xzhang03/NidaqGUI/PCBs/LED cue pwmint/readme.md

LED cue takes a PWM signal and turns RGB LED on/off. 

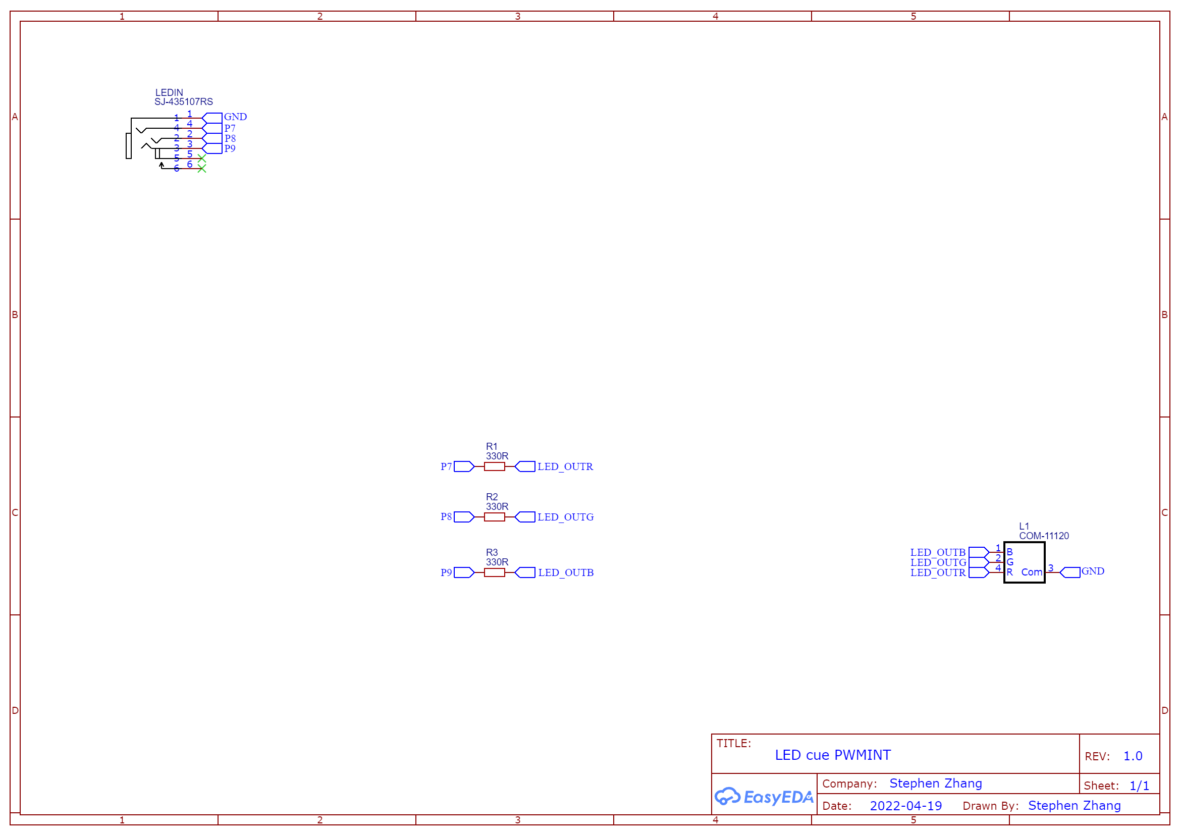
[picture p10: PCBs/LED cue pwmint/Schematic_LED-cue-pwm3_2026-06-25.png]
schematic
