xzhang03/NidaqGUI/PCBs/Nanosec/readme.md

## Notes
* Max 3.3V output current is 250 mA.
* No pin is 5V tolerant!
* Possible upgrades: DAC, EEPROM, status LEDs, independent 3.3V regulator, coin cell holder for onboard RTC.

## Schematics

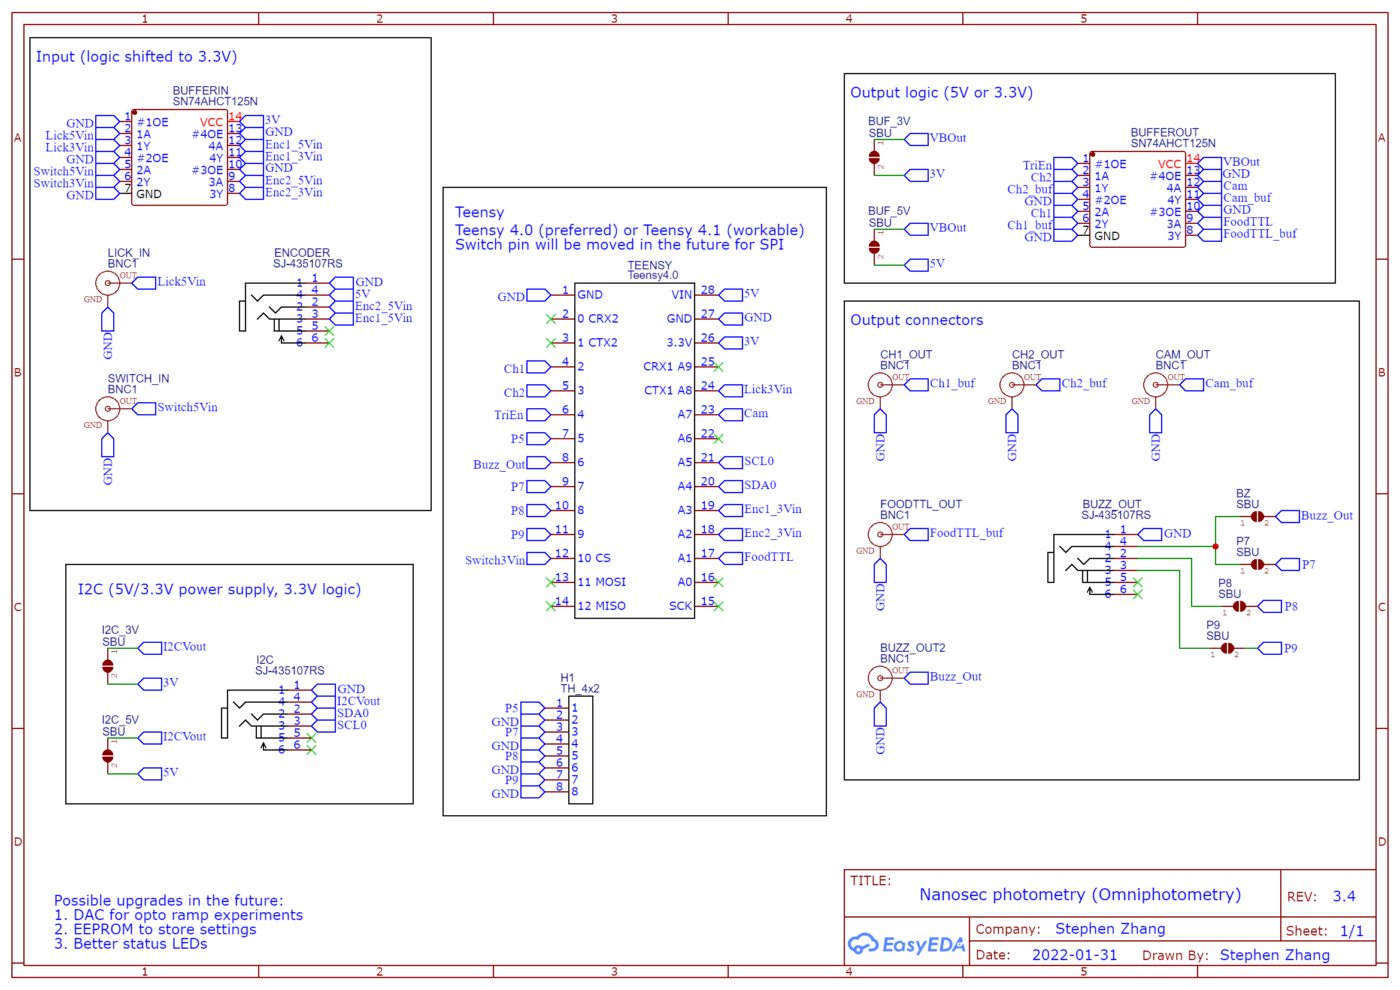
[picture p11: PCBs/Nanosec/Schematic_Omnibox-v3_2026-06-24.png]
Schematics


## Footprint

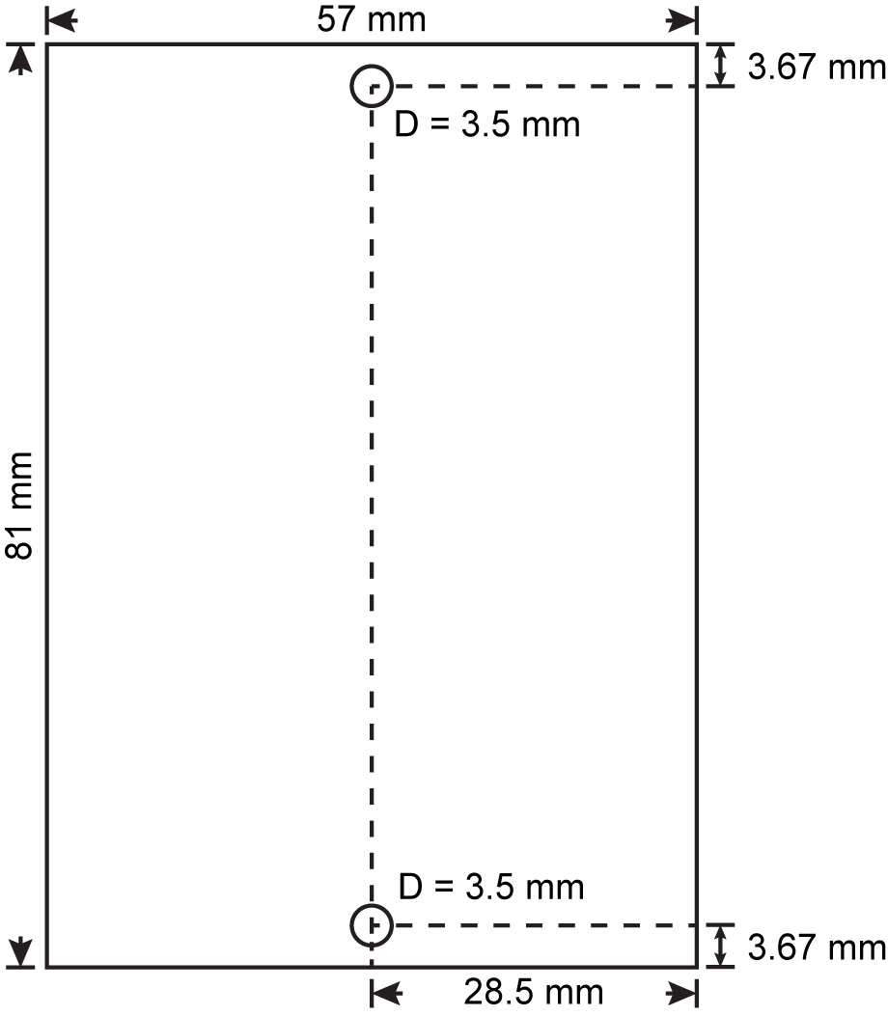
[picture p12: PCBs/Nanosec/Board footprint.png]
Footprint
