xzhang03/NidaqGUI/PCBs/LED cue/readme.md

LED cue takes a digital signal or PWM signal and turns LED on/off. The wavelength is programmed by a DIM switch on the board in this version as it is to plug in the buzzer cable. Use the I2c version for flexible wavelength control. Only 2 channels of the audio jack are used (LED+ and ground).

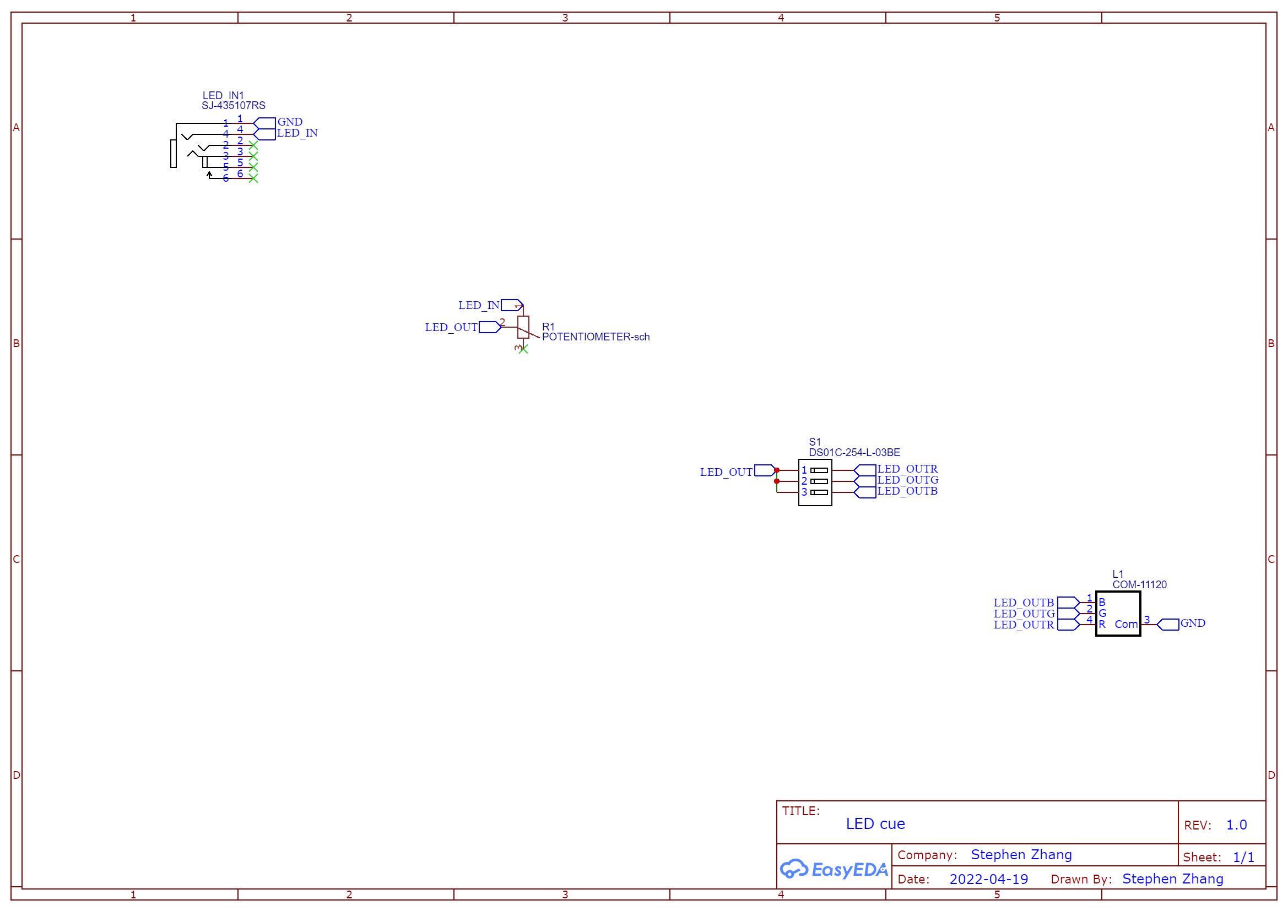
[picture p18: PCBs/LED cue/Schematic_LED cue_2022-04-19.png]
schematic
