xzhang03/NidaqGUI/PCBs/Buzzer/readme.md

Buzzer uses a PWM signl and turns it into a ~2.1 kHz buzz. The frequency of buzz is not programmable at the moment. Only two channels of the audio cable are used (buzz positive and ground).

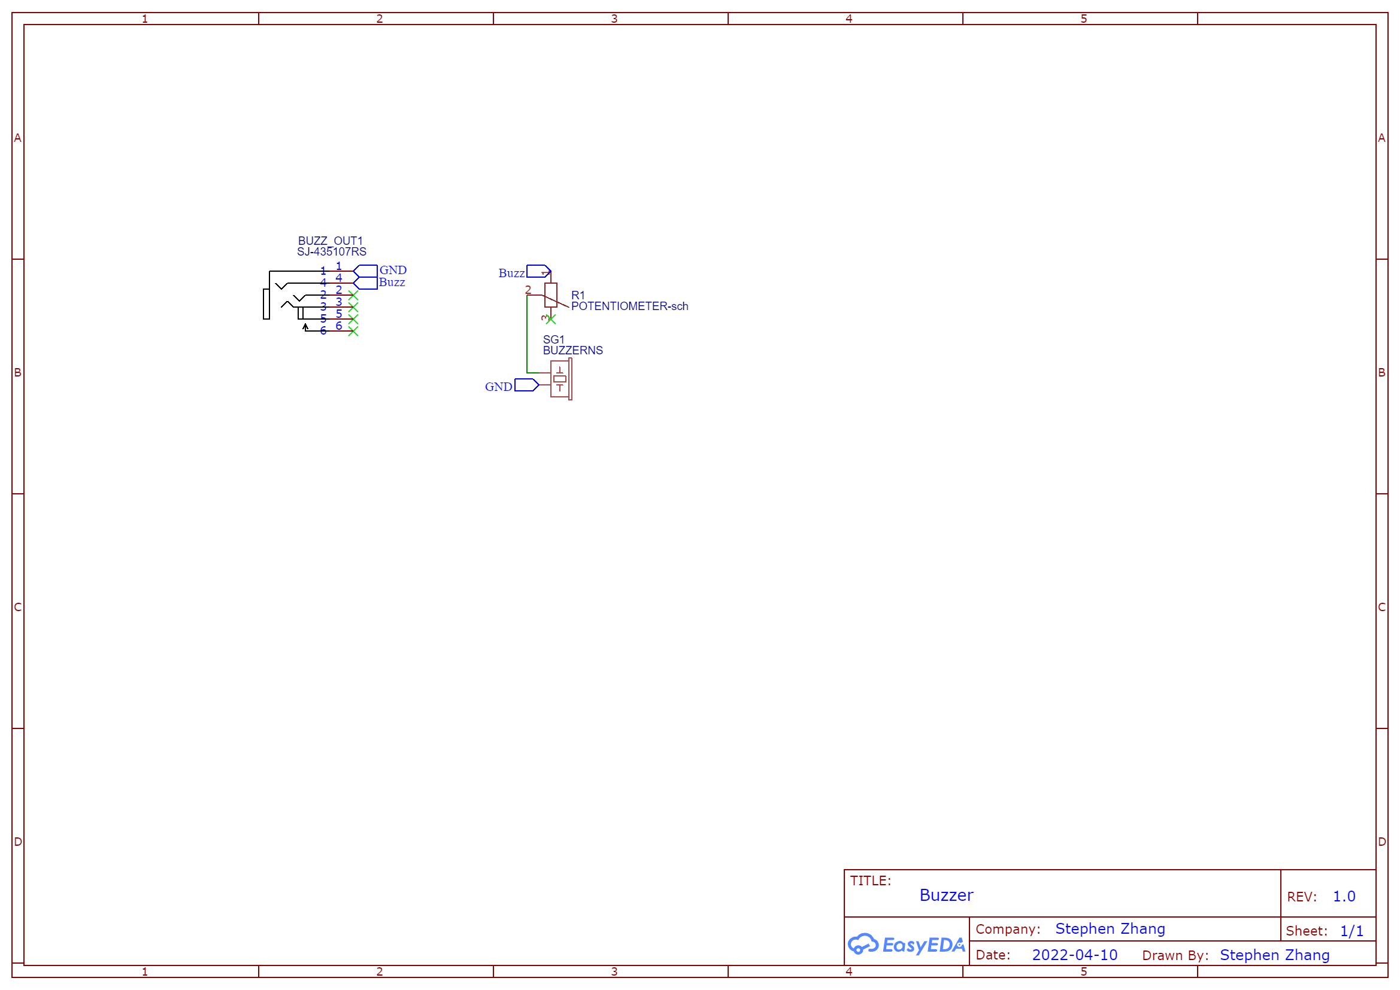
[picture p19: PCBs/Buzzer/Schematic_Buzzer_2022-04-13.png]
Schematic
