xzhang03/NidaqGUI/PCBs/Rotary Encoder/encoder_footprint.png

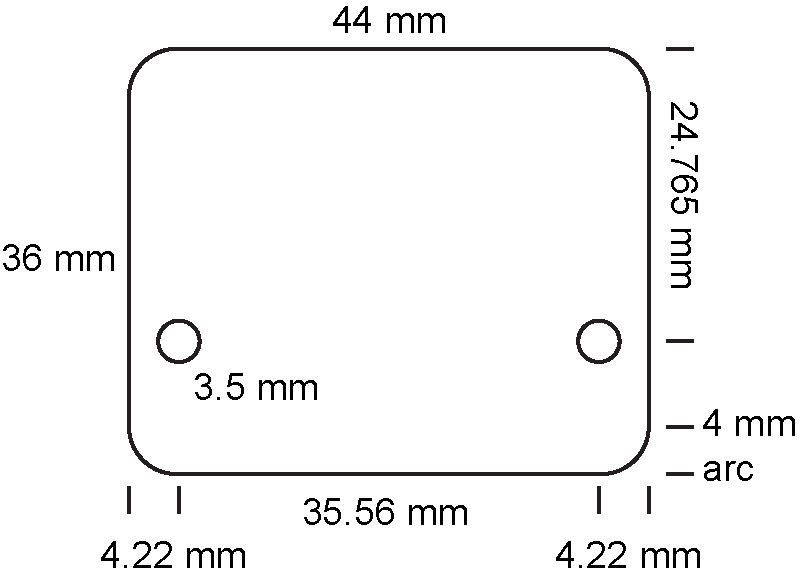
PCBs/Rotary Encoder/encoder_footprint.png
