xzhang03/NidaqGUI/PCBs/Shifter v2/Schematic_Nanosec-Shifter2_2025-11-14.png

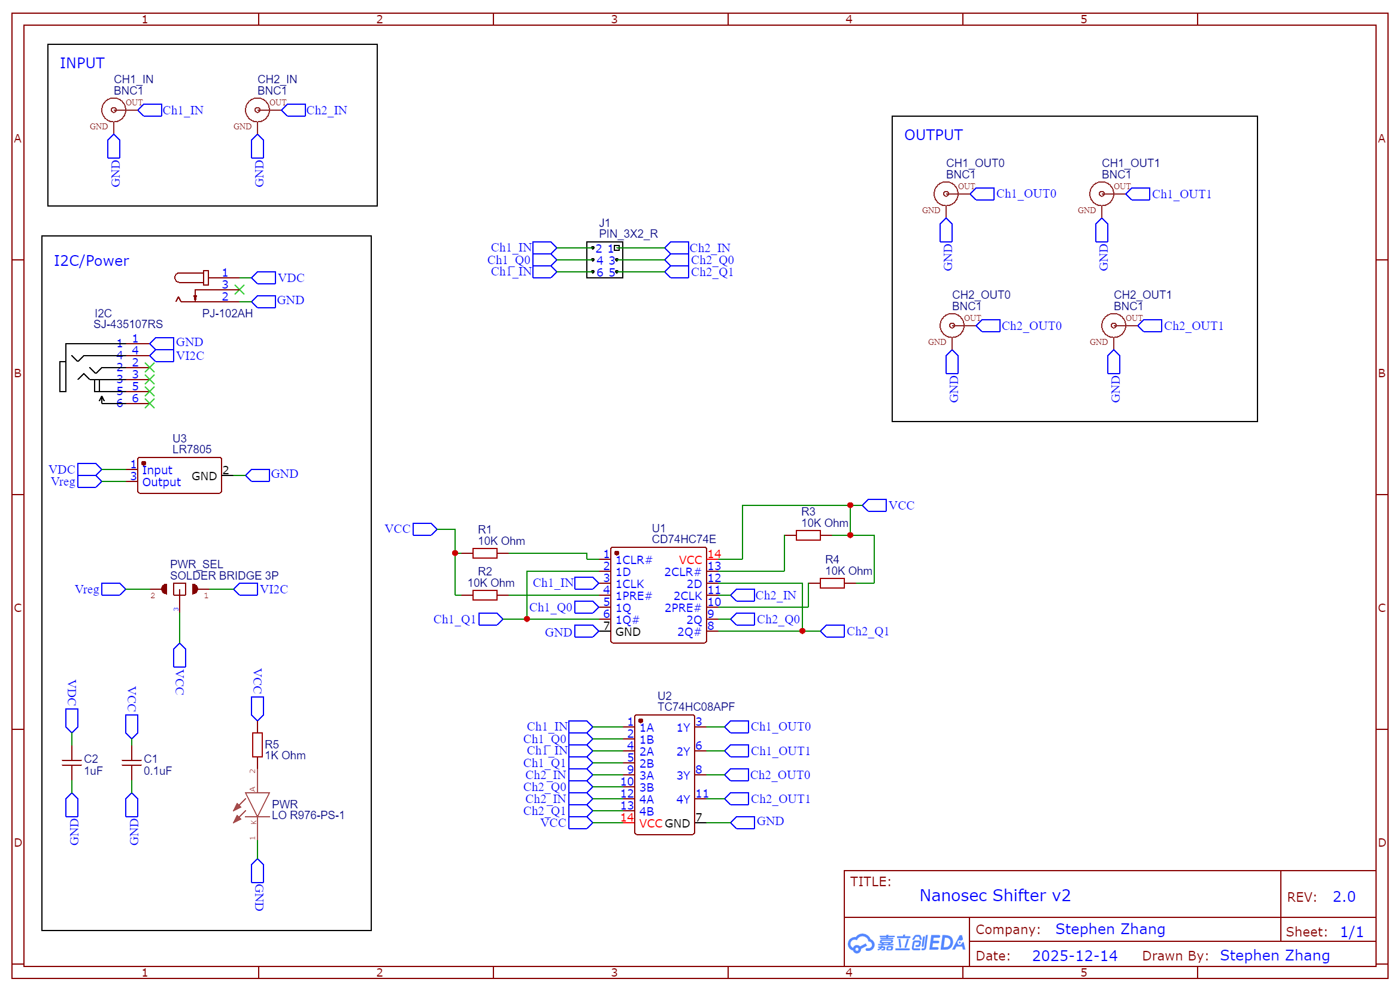
PCBs/Shifter v2/Schematic_Nanosec-Shifter2_2025-11-14.png
