xzhang03/NidaqGUI/Schemes/omnibox_half_breadboard.png

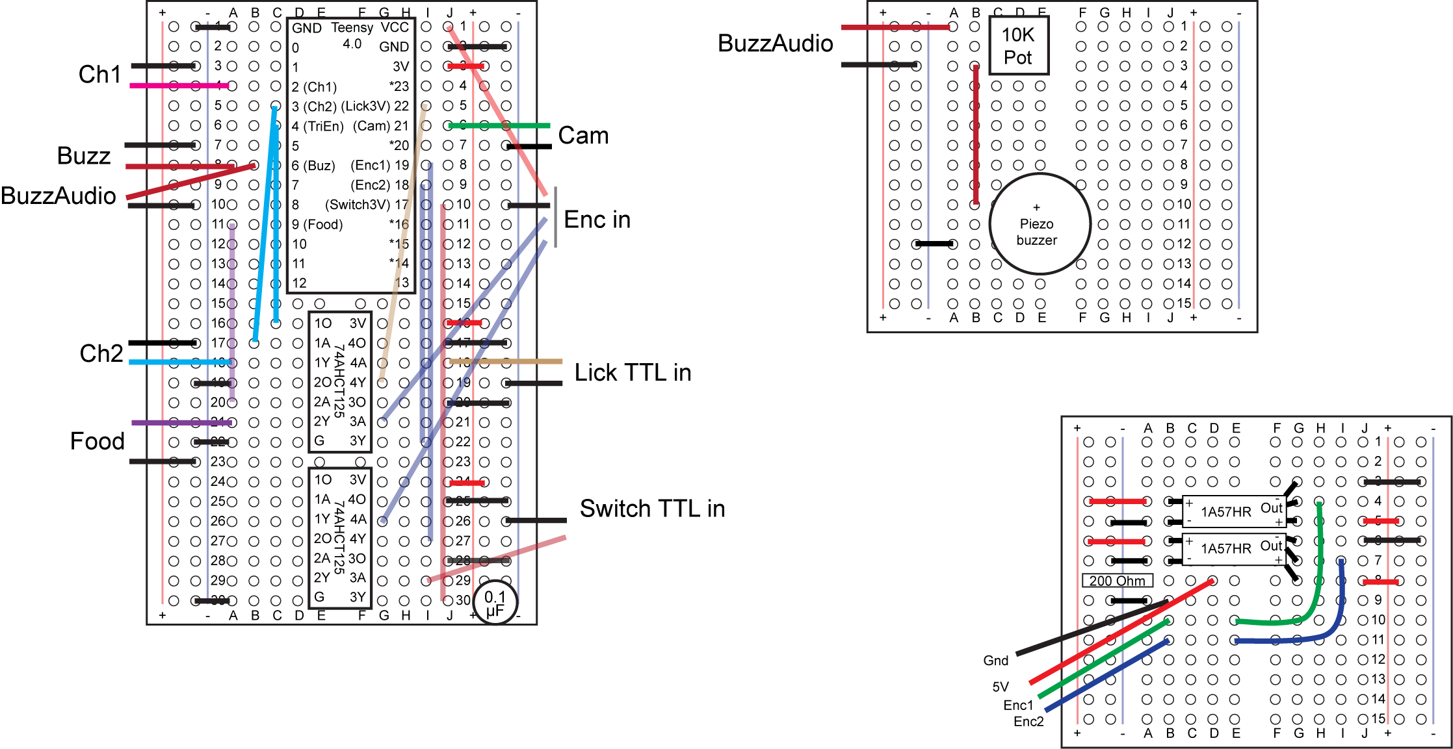
Schemes/omnibox_half_breadboard.png
