xzhang03/NidaqGUI/Schemes/Schematic_TQMux_2022-06-06.png

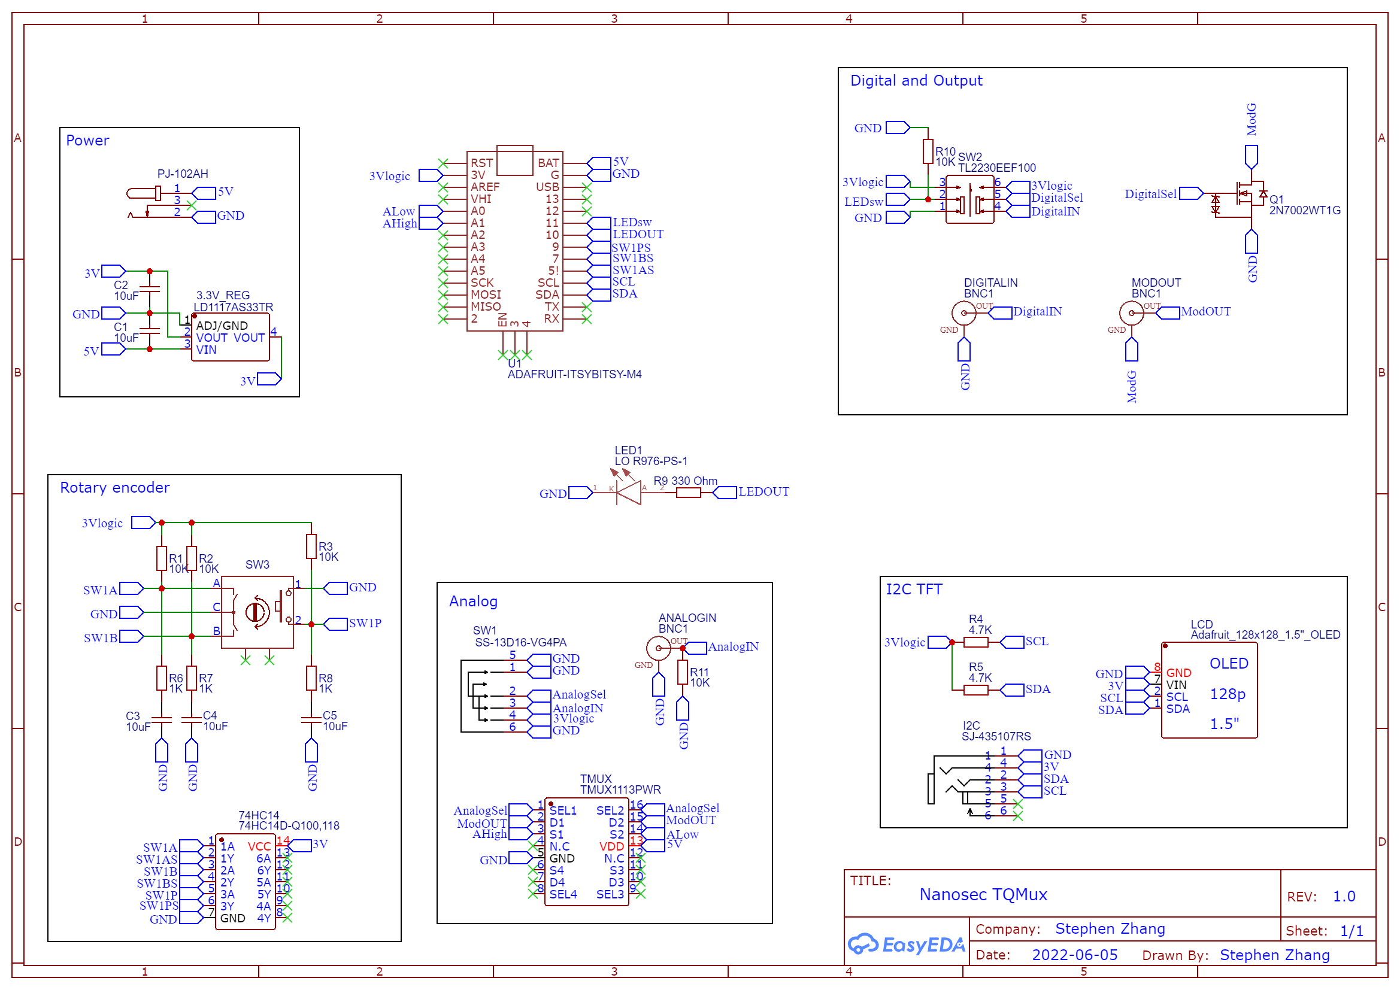
Schemes/Schematic_TQMux_2022-06-06.png
