xzhang03/NidaqGUI/PCBs/Buzzer/Nanosec Buzzer BOM.xlsx

Country of Origin may be different at time of shipment.
The HTSUS and ECCN information shown is for informational purposes only and is not a representation or warranty as to the accuracy or reliability of these classifications. All information is provided "as is" and is subject to change without notice. Any use made of the information provided is without recourse to Digi-Key and at the user's risk.
Index | Manufacturer Part Number | Manufacturer Name | Description | Availability | Stock Status | Attrition % | Requested Quantity 1 | Pack Quantity 1 | Pack Type 1 | Digi-Key Part Number 1 | Unit Price 1 | Extended Price 1 | Minimum Order Quantity 1 | Customer Reference | Requested Part Number | Lead Weeks | Datasheet | Reference Designator | US Import Tariff | Note | Part Status | RoHS Status | ECCN | HTSUS | Country of Origin | Environmental Information | Original Part numbers | Image
1 | CEM-1203(42) | CUI Devices | BUZZER MAGNETIC 3.5V 12MM TH | 66,838 | In Stock |  | 1 | 1 | Tray | 102-1153-ND | 0.75000 | $0.75 | 1 |  | 102-1153-ND | 15 | https://www.cuidevices.com/product/resource/cem-1203-42-.pdf |  | May apply on shipments to the U.S. |  | Active | ROHS3 Compliant | EAR99 | 8531.80.9041 | China | https://www.cuidevices.com/product/resource/material-compliance/cem-1203(42) | 102-1153-ND | //media.digikey.com/photos/CUI%20Photos/CEM-1203(42).jpg
2 | 3266Y-1-103LF | Bourns Inc. | TRIMMER 10K OHM 0.25W PC PIN TOP | 0 | Normally Stocking |  | 1 | 1 | Tube | 3266Y-1-103LF-ND | 4.20000 | $4.20 | 1 |  | 3266Y-1-103LF-ND | 15 | https://www.bourns.com/docs/Product-Datasheets/3266.pdf |  | N/A |  | Active | ROHS3 Compliant | EAR99 | 8533.40.8050 | Costa Rica | https://www.bourns.com/docs/rohs-content/bourns-reach-letter.pdf|https://www.bourns.com/docs/rohs-cofc/cofc_trim4.pdf?sfvrsn=41f62244_2 | 3266Y-1-103LF-ND | //media.digikey.com/Photos/Bourns%20Photos/3266Y-1-501LF.JPG
3 | SJ-435107RS | CUI Devices | CONN JACK 4COND 3.5MM R/A | 15,403 | In Stock |  | 1 | 1 | Tray | CP-435107RS-ND | 1.78000 | $1.78 | 1 |  | SJ-435107RS | 24 | https://www.cuidevices.com/product/resource/sj-435107.pdf |  | N/A |  | Active | ROHS3 Compliant | EAR99 | 8536.69.4040 | China | https://www.cuidevices.com/product/resource/material-compliance/sj-435107-series | SJ-435107RS | //media.digikey.com/Photos/CUI%20Photos/MFG_SJ-435107.jpg
