xzhang03/NidaqGUI/PCBs/LED cue/Nanosec LED Cue BOM.xlsx

Country of Origin may be different at time of shipment.
The HTSUS and ECCN information shown is for informational purposes only and is not a representation or warranty as to the accuracy or reliability of these classifications. All information is provided "as is" and is subject to change without notice. Any use made of the information provided is without recourse to Digi-Key and at the user's risk.
Index | Manufacturer Part Number | Manufacturer Name | Description | Availability | Stock Status | Attrition % | Requested Quantity 1 | Pack Quantity 1 | Pack Type 1 | Digi-Key Part Number 1 | Unit Price 1 | Extended Price 1 | Minimum Order Quantity 1 | Customer Reference | Requested Part Number | Lead Weeks | Datasheet | Reference Designator | US Import Tariff | Note | Part Status | RoHS Status | ECCN | HTSUS | Country of Origin | Environmental Information | Original Part numbers | Image
1 | SJ-435107RS | CUI Devices | CONN JACK 4COND 3.5MM R/A | 15,403 | In Stock |  | 1 | 1 | Tray | CP-435107RS-ND | 1.78000 | $1.78 | 1 |  | CP-435107RS-ND | 24 | https://www.cuidevices.com/product/resource/sj-435107.pdf |  | N/A |  | Active | ROHS3 Compliant | EAR99 | 8536.69.4040 | China | https://www.cuidevices.com/product/resource/material-compliance/sj-435107-series | CP-435107RS-ND | //media.digikey.com/Photos/CUI%20Photos/MFG_SJ-435107.jpg
2 | 3296W-1-102LF | Bourns Inc. | TRIMMER 1K OHM 0.5W PC PIN TOP | 20,122 | In Stock |  | 1 | 1 | Tube | 3296W-102LF-ND | 2.43000 | $2.43 | 1 |  | 3296W-102LF-ND | 18 | https://www.bourns.com/docs/product-datasheets/3296.pdf |  | N/A |  | Active | ROHS3 Compliant | EAR99 | 8533.40.8050 | Costa Rica | https://www.bourns.com/docs/rohs-cofc/cofc_trim1.pdf?sfvrsn=ec972807_4 | 3296W-102LF-ND | //media.digikey.com/photos/Bourns%20Photos/3296W%20SERIES.jpg
3 | DS01C-254-L-03BE | CUI Devices | DIP SWITCH, SPST, 2.54 PITCH, RA | 1,009 | In Stock |  | 1 | 1 | Tube | 2223-DS01C-254-L-03BE-ND | 0.57000 | $0.57 | 1 |  | 2223-DS01C-254-L-03BE-ND | 10 | https://www.cuidevices.com/product/resource/ds01-254.pdf |  | May apply on shipments to the U.S. |  | Active | ROHS3 Compliant | EAR99 | 8536.50.9065 | China | https://www.cuidevices.com/product/resource/material-compliance/ds01-254-series | 2223-DS01C-254-L-03BE-ND | //media.digikey.com/Photos/CUI%20Photos/MFG_DS01-254-03.jpg
4 | COM-11120 | SparkFun Electronics | LED RGB DIFFUSED T/H | 975 | In Stock |  | 1 | 1 | Bulk | 1568-1215-ND | 1.15000 | $1.15 | 1 |  | 1568-1215-ND | 6 | http://cdn.sparkfun.com/datasheets/Components/General/YSL-R1047CR4G3BW-F8.pdf |  | N/A |  | Active | ROHS3 Compliant | EAR99 | 8541.41.0000 | China |  | 1568-1215-ND | //media.digikey.com/Photos/Sparkfun%20Elec%20%20Photos/COM-11120.JPG
