xzhang03/NidaqGUI/PCBs/Nanosec/Nanosec Photometry BOM.xlsx

Country of Origin may be different at time of shipment.
The HTSUS and ECCN information shown is for informational purposes only and is not a representation or warranty as to the accuracy or reliability of these classifications. All information is provided "as is" and is subject to change without notice. Any use made of the information provided is without recourse to Digi-Key and at the user's risk.
Index | Manufacturer Part Number | Manufacturer Name | Description | Availability | Stock Status | Attrition % | Requested Quantity 1 | Pack Quantity 1 | Pack Type 1 | Digi-Key Part Number 1 | Unit Price 1 | Extended Price 1 | Minimum Order Quantity 1 | Customer Reference | Requested Part Number | Lead Weeks | Datasheet | Reference Designator | US Import Tariff | Note | Part Status | RoHS Status | ECCN | HTSUS | Country of Origin | Environmental Information | Original Part numbers | Image
1 | 0731375003 | Molex | CONN BNC RCPT R/A 50 OHM PCB | 29,365 | In Stock |  | 7 | 7 | Tray | WM5514-ND | 2.65000 | $18.55 | 1 |  | WM5514-ND | 12 | https://www.molex.com/pdm_docs/sd/731375003_sd.pdf |  | N/A |  | Active | ROHS3 Compliant | EAR99 | 8536.69.4010 | Taiwan |  | WM5514-ND | //media.digikey.com/Photos/Molex/0731375003.jpg
2 | SJ-435107RS | CUI Devices | CONN JACK 4COND 3.5MM R/A | 15,403 | In Stock |  | 3 | 3 | Tray | CP-435107RS-ND | 1.78000 | $5.34 | 1 |  | CP-435107RS-ND | 24 | https://www.cuidevices.com/product/resource/sj-435107.pdf |  | N/A |  | Active | ROHS3 Compliant | EAR99 | 8536.69.4040 | China | https://www.cuidevices.com/product/resource/material-compliance/sj-435107-series | CP-435107RS-ND | //media.digikey.com/Photos/CUI%20Photos/MFG_SJ-435107.jpg
3 | SN74AHCT125N | Texas Instruments | IC BUF NON-INVERT 5.5V 14DIP | 2,281 | In Stock |  | 2 | 2 | Tube | 296-4655-5-ND | 0.60000 | $1.20 | 1 |  | 296-4655-5-ND | 26 | https://www.ti.com/general/docs/suppproductinfo.tsp?distId=10 |  | N/A |  | Active | ROHS3 Compliant | EAR99 | 8542.39.0001 | Malaysia |  | 296-4655-5-ND | //media.digikey.com/Photos/Texas%20Instr%20Photos/Mfg_296~4040049~N~14.jpg
4 | ICS-628-T | Adam Tech | IC SOCKET, DIP, 28P 2.54MM PITCH | 1,607 | In Stock |  | 1 | 1 | Tube | 2057-ICS-628-T-ND | 0.29000 | $0.29 | 1 |  | 2057-ICS-628-T-ND | 9 | https://app.adam-tech.com/products/download/data_sheet/199581/ics-6xx-t-data-sheet.pdf |  | N/A |  | Active | ROHS3 Compliant | EAR99 | 8536.69.4040 | Taiwan |  | 0.7inch 28 Pin DIP socket | //media.digikey.com/Photos/Adam-Tech/MFG_ICS-628-T.JPG
5 | DEV-15583 | SparkFun Electronics | TEENSY 4.0 | 0 | Normally Stocking |  | 1 | 1 | Bulk | 1568-DEV-15583-ND | 21.88000 | $21.88 | 1 |  | 1568-DEV-15583-ND | 6 | //media.digikey.com/pdf/Data%20Sheets/Sparkfun%20PDFs/DEV-15583_Web.pdf |  | N/A |  | Active | ROHS3 Compliant | 5A992C SC | 8473.30.1180 | United States |  | 1568-DEV-15583-ND | //media.digikey.com/Photos/Sparkfun%20Elec%20%20Photos/DEV-15583.JPG
6 | 09200-71-BBGB00 | METZ CONNECT USA Inc. | MINI JUMPER, SHUNT, 2.54MM, OPEN | 35,556 | In Stock |  | 2 | 2 | Bulk | 1849-09200-71-BBGB00-ND | 0.10000 | $0.20 | 1 |  | 1849-09200-71-BBGB00-ND | 7 | https://www.metz-connect.com/externalfiles/09200-71-BBGB00/916569.PDF |  | N/A |  | Active | ROHS3 Compliant | EAR99 | 8538.90.8180 | Taiwan |  | 1849-09200-71-BBGB00-ND | //media.digikey.com/Photos/METZ CONNECT USA Inc. Photos/MFG_09200-71-BBGB00.jpg
