xzhang03/NidaqGUI/PCBs/Rotary Encoder/Nanosec Encoder BOM.xlsx

Country of Origin may be different at time of shipment.
The HTSUS and ECCN information shown is for informational purposes only and is not a representation or warranty as to the accuracy or reliability of these classifications. All information is provided "as is" and is subject to change without notice. Any use made of the information provided is without recourse to Digi-Key and at the user's risk.
Index | Manufacturer Part Number | Manufacturer Name | Description | Availability | Stock Status | Attrition % | Requested Quantity 1 | Pack Quantity 1 | Pack Type 1 | Digi-Key Part Number 1 | Unit Price 1 | Extended Price 1 | Minimum Order Quantity 1 | Customer Reference | Requested Part Number | Lead Weeks | Datasheet | Reference Designator | US Import Tariff | Note | Part Status | RoHS Status | ECCN | HTSUS | Country of Origin | Environmental Information | Original Part numbers | Image
1 | GP1A57HRJ00F | SHARP/Socle Technology | SENSOR OPTICAL 10MM PCB MOUNT | 24,189 | In Stock |  | 2 | 2 | Bulk | 1855-1043-ND | 4.48000 | $8.96 | 1 |  | 1855-1043-ND | 20 | http://www.socle-tech.com/doc/IC%20Channel%20Product/Optoelectronic%20Components/Photointerrupter/Transmissive%20type/gp1a57hr_e.pdf |  | May apply on shipments to the U.S. |  | Active | RoHS Compliant | EAR99 | 8541.49.8000 | China |  | 1855-1043-ND | //media.digikey.com/Photos/Sharp%20Photos/GP1A57HRJ00F.JPG
2 | CFR-25JT-52-200R | YAGEO | RES 200 OHM 5% 1/4W AXIAL | 7,110 | In Stock |  | 1 | 1 | Cut Tape (CT) | 13-CFR-25JT-52-200RCT-ND | 0.10000 | $0.10 | 1 |  | 13-CFR-25JT-52-200RCT-ND | 16 | https://www.yageo.com/upload/media/product/productsearch/datasheet/lr/YAGEO%20CFR_datasheet_2021v0.pdf |  | N/A |  | Active | ROHS3 Compliant | EAR99 | 8533.10.0065 | Taiwan |  | 13-CFR-25JT-52-200RCT-ND | //media.digikey.com/Renders/Yageo%20Renders/200-Ohm-Axial-5%25-CFR-Series.jpg
3 | SJ-435107RS | CUI Devices | CONN JACK 4COND 3.5MM R/A | 15,403 | In Stock |  | 1 | 1 | Tray | CP-435107RS-ND | 1.78000 | $1.78 | 1 |  | SJ-435107RS | 24 | https://www.cuidevices.com/product/resource/sj-435107.pdf |  | N/A |  | Active | ROHS3 Compliant | EAR99 | 8536.69.4040 | China | https://www.cuidevices.com/product/resource/material-compliance/sj-435107-series | SJ-435107RS | //media.digikey.com/Photos/CUI%20Photos/MFG_SJ-435107.jpg
