xzhang03/NidaqGUI/(list of files, drawings)

Other design files:
PCB_omni/EasyEDA_PCB_IR rotary encoder v1.json
PCBs/Buzzer/EasyEDA_PCB_Buzzer_2022-04-13.json
PCBs/DIO expander/PCB_PCB_Nanosec DIO_2023-01-03.json
PCBs/DIO expander/SCH_Nanosec DIO_2023-01-03.json
PCBs/I2C repeater/PCB_PCB_I2C-repeater_2026-06-25.json
PCBs/I2C repeater/SCH_I2C-repeater_2024-11-25.json
PCBs/LED cue i2c/PCB_PCB_LED-cue-I2C_2026-06-26.json
PCBs/LED cue i2c/SCH_LED-cue-I2C_2026-06-26.json
PCBs/LED cue pwmint/PCB_PCB_LED-cue-pwm3_2026-06-25.json
PCBs/LED cue pwmint/SCH_LED-cue-pwm3_2026-06-25.json
PCBs/LED cue/EasyEDA_PCB_LED cue_2022-04-19.json
PCBs/Nanosec/PCB_PCB_Omnibox-v3_2026-06-24.json
PCBs/Nanosec/SCH_Omnibox-v3_2026-06-24.json
PCBs/Rotary Encoder/PCB_PCB_IR rotary encoder v1_2023-01-03.json
PCBs/Shifter v2/PCB_PCB_Nanosec-Shifter-copy_2025-11-14.json
PCBs/Shifter v2/SCH_Nanosec-Shifter2_2025-11-14.json
PCBs/Shifter/EasyEDA_PCB_Nanosec Shifter_2022-09-27.json
PCBs/Shifter/EasyEDA_SCH_Nanosec Shifter_2022-09-27.json
