xzhang03/NidaqGUI/Arduino/nanosec/2_sem.ino

// m table
// ========== Operational ==========
// 2: new cycle time (1000000/n, n in Hz)
// 85: Camera pulse on time (n = ms)
// 1: start pulse
// 0: stop pulse
// 5: Quad encoder position
// 9: Show all parameters
// 252: Universal identifier
// 253: reboot (n = 104)
// 254: version
// 255: status update (n = variable)
// 75: Turn on cam pulsing (send any serial to stop) [{]

// ========== Opto & photom ==========
// 3: TCP mode (n = 0 TCP, n = 1 optophotometry, n = 2 samecolor optophotometry)
// 6: Change opto frequency (opto_per = n, f = 50/n)
// 7: Change opto pulse per train (train_length = n)
// 8: Change opto train cycle (train_cycle = n * 50, n in seconds)
// 59: Opto-photometry overlap (n = 1 yes, 0 no) [k]
// 10: Change scopto frequency (scopto_per = n, f = 50/n) [:]
// 11: Change scopto train cycle (train_cycle = n * 50) [;]
// 12: Change scopto pulse per train (train_length = n) [<]
// 13: Change scopto pulse width (n * 1000 us) [=]
// 14: Change Opto pulse width (n * 1000 us) [>]
// 29: Tristate pin polarity (1 = active high, 0 = active low) [M]
// 47: Change tcp behavioral train cycle (train_cycle = n * 50) [_]
// 36: Cycle 1 for optophotometry (only changed for pure optogenetic experiments; cycle = n * 100 us) [T]
// 37: Cycle 2 for optophotometry (only changed for pure optogenetic experiments; cycle = n * 100 us) [U]
// 55: Add Cycle 1 for optophotometry (cycle = cycle + n * 256 * 100 us) [g]
// 56: Add Cycle 2 for optophotometry (cycle = cycle + n * 256 * 100 us) [h]
// 53: Cycle 1 for TCP (only changed for pure TCP experiments; cycle = n * 100 us) [e]
// 54: Cycle 2 for TCP (only changed for pure TCP experiments; cycle = n * 100 us) [f]
// 57: Add Cycle 1 for TCP (cycle = cycle + n * 256 * 100 us) [i]
// 58: Add Cycle 2 for TCP (cycle = cycle + n * 256 * 100 us) [j]
// 78: Cycle 1 for SCoptophotometry (only changed for pure scopto experiments; cycle = n * 100 us) [~]
// 79: Cycle 2 for SCoptophotometry (only changed for pure scopto experiments; cycle = n * 100 us) []
// 80: Add Cycle 1 for scopto (cycle = cycle + n * 256 * 100 us) []
// 81: Add Cycle 2 for scopto (cycle = cycle + n * 256 * 100 us) []

// ============ Scheduler ============
// 15: Use scheduler (n = 1 yes, 0 no) [?]
// 4: Set delay (delay_cycle = n * 50, n = 1 means 1 second). Only relevant when scheduler is on
// 52: Adding delay (n * 256 * 50, n = 1 means 256 second). Only relevant when scheduler is on [d]
// 16: Number of trains (n trains) [@]
// 46: Adding trains (trains = trains + n * 256) [^]
// 17: Enable manual scheduler override [A]
// 27: Listening mode on or off (n = 1 yes, 0 no). Will turn on manual override [K]
// 28: Listen mode polarity (1 = active high, 0 = active low) [L]
// 69: Turn on scheduler indicator (PCA9685/PWMINT/audiopin) (n = 3 audiopin, 2 PWMINT, 1 PCA9685, 0 no)[u]
// 70: Preopto PCA9685/PWMINT color [0 Shared_bit R R G G B B] [v]
// 71: Inopto PCA9685/PWMINT color [0 Shared_bit R R G G B B] [w]
// 72: Postopto PCA9685/PWMINT color [0 Shared_bit R R G G B B] [x]
// 73: Post-recording PCA9685/PWMINT color (0: off, 1: stay, 2: preopto, 3: inopto, 4: postopto)[y]

// ============ Hardware RNG ============
// 38: use RNG or not (n = 1 yes, 0 no) [V]
// 39: Pass chance in percent (30 = 30% pass chance) [W]
// 40: RNG ITI or not (n = 1 yes, 0 no) [X]
// 41: min randomized ITI (n * 1 s) [Y]
// 42: max randomized ITI (n * 2 s) [Z]
// 64: Report RNG (n = 0 ITI, 1 opto, 2 trialtype)[p]

// ============ Food TTL ============
// 24: Use Food TTL or not (n = 1 yes, 0 no)  [H]
// 18: Delay time after opto (n * 100 ms) [B]
// 50: Adding delay time after opto (n * 256 * 100 ms) [b]
// 19: Pulse on time (n * 10 ms) [C]
// 20: Pulse cycle time (n * 10 ms) [D]
// 21: Pulses per train (n) [E]
// 30: Use food cue or not (n = 1 yes, 0 no) [N]
// 31: Cue delay (n * 100 ms) [O]
// 32: Cue duration (n * 100 ms) [P]
// 48: Opto then Food (n = 1 yes, 0 no) [`]
// 49: Lead time before opto (n s) [a]
// 51: Adding lead time before opto (+ n * 256 s) [c]
// 74: Test food TTLs (150-ms on/150-ms off, n = cycles) [z]
// 82: Use food RNG (n = 1 yes, 0 no)
// 83: Food RNG pass chance (n = 0-100);

// ====== Food TTL Conditional ======
// 22: Conditional or not (n = 1 yes, 0 no) [F]
// 33: Action period delay (n * 100 ms) [Q]
// 34: Action period duration (n * 100 ms) [R]
// 35: Delivery period duration (n * 100 ms) [S]
// 82: Use food RNG (n = 1 yes, 0 no)
// 83: Food RNG pass chance (n = 0-100);

// ====== Multi trial type ======
// 62: Max trial types (n = 1-4)[n]
// 63: Current trialtype to edit (n = 0 - 3)[o]
// 65: Trial IO upper byte (n = MSB)[q]
// 66: Trial IO lower byte (n = LSB)[r]
// 67: Trial frequency weight (n = weight)[s]
// 76: RNG vs deterministic Trial type (n = 255 for RNG, n = 0 for writing Trials 0-3, n = 1 for writing Trials 4-7,...)[|]
// 77: Deterministic trial type ([+0 MSB, +0 LSB, +1 MSB, +1 LSB, +2 MSB, +2 LSB, +3 MSB, +3 LSB])[}]

// ============= Encoder =============
// 23: Encoder useage (n = 1 yes, 0 no) [G]
// 43: Auto encoder serial transmission (n = 1 yes, 0 no) [[]

// ============ Audio sync ============
// 25: Audio sync (n = 1 yes, 0 no) [I]
// 26: Audio sync tone frequency (n * 100 Hz) [J]

// ========== Trial and RNG Echo ==========
// 44: Auto trial and rng echo (n = 1 yes, 0 no) [\]
// 45: Auto trial and rng echo periodicity (n * 100 ms) []]

// ============== i2c ==============
// 60: Scan i2c addresses [l]
// 61: Test PCA9685 [m]
// 68: Test MCP23008 [t]
// 84: Ping known i2c address

// 86: Test audiopin (3 pulses, 500 ms on/off)
// 87: Test PWMINT (RGB sweep)
// 88:
// 89: 
// 90: 
// 91: 
// 92: 
// 93: 
// 94: 
// 95: 
// 96: 
// 97: 
// 98: 
// 99: 
// 100: 
// 101: 
// 102: 
// 103: 
// 104: 
// 105: 
