xzhang03/NidaqGUI/(commit log)

2020-01-21 added additional quad encoder support
2020-01-23 quad encoders
2021-07-08 update arduino code
2021-07-08 updated for better arduino support
2022-02-02 Create Schematic_Omnibox v3_2022-02-02.png
2022-02-03 switched pins around
2022-03-24 updated PCB
    [EasyEDA_PCB_Omnibox v3_2022-03-24.json]
2022-04-06 fixed pcb bugs
    [EasyEDA_PCB_Omnibox v3_2022-03-24.json, EasyEDA_PCB_Omnibox v3_2022-04-06.json]
2022-04-08 Bug fixes for PCB
    [EasyEDA_PCB_Omnibox v3.json, EasyEDA_PCB_Omnibox v3_2022-04-06.json]
2022-04-13 gerber updates
    [EasyEDA_PCB_Buzzer_2022-04-13.json, EasyEDA_PCB_IR rotary encoder v1.json, EasyEDA_PCB_Omnibox v3.json]
2022-04-19 LED cue
    [EasyEDA_PCB_LED cue_2022-04-19.json]
2022-04-19 Update Schematic_LED cue_2022-04-19.png
2022-04-26 gerber error
    [EasyEDA_PCB_Omnibox v3.json]
2022-05-06 pcb transition
2022-05-09 fixed a pin conflict
    [omniphotometrybox.ino]
2022-06-07 hardware for TCube support
    [EasyEDA_PCB_TQMux_2022-06-06.json]
2022-09-16 Bill of materials
    [EasyEDA_PCB_TQMux_2022-06-06.json, Nanosec Buzzer BOM.xlsx, Nanosec Encoder BOM.xlsx, Nanosec LED Cue BOM.xlsx, Nanosec Photometry BOM.xlsx]
2022-10-06 conditional reward bug fix
    [omniphotometrybox.ino]
2022-10-31 Create Nanosec Shifter BOM.xlsx
    [Nanosec Shifter BOM.xlsx]
2023-01-03 Organizational changes
    [EasyEDA_PCB_Buzzer_2022-04-13.json, EasyEDA_PCB_LED cue_2022-04-19.json, EasyEDA_PCB_Nanosec Shifter_2022-09-27.json, EasyEDA_PCB_Omnibox v3.json, EasyEDA_SCH_Nanosec Shifter_2022-09-27.json, Nanosec Buzzer BOM.xlsx, Nanosec Encoder BOM.xlsx, Nanosec LED Cue BOM.xlsx]
2023-01-05 updated schematic
2023-03-28 added i2c scan
2023-07-04 Encoder test panel
2023-08-30 Create TRRS i2c.png
2025-11-14 updated pcbs
    [PCB_PCB_Nanosec-Shifter-copy_2025-11-14.json, SCH_Nanosec-Shifter2_2025-11-14.json]
2026-03-05 i2c connectivity ping
2026-06-19 ns v3.63
    added marker for i2c tests
2026-06-21 ns v3.64
    Mitigated EMP during pwm cue offset
2026-06-24 ns v3.65
    Added internal RGB PWM cue type (3 channels)
2026-06-24 new PCB
    [PCB_PCB_Omnibox-v3_2024-11-25.json, PCB_PCB_Omnibox-v3_2026-06-24.json, SCH_Omnibox-v3_2024-11-25.json, SCH_Omnibox-v3_2026-06-24.json]
2026-06-25 pwmint cue pcb
    [PCB_PCB_LED-cue-pwm3_2026-06-25.json, SCH_LED-cue-pwm3_2026-06-25.json]
2026-07-16 camera pulse on time
2026-07-17 ns v3.66
    subsetting PCA9685 due to uncontrollable EMI
    [2_food.ino, 2_sem.ino]
2026-07-17 Add default case to getcuetype() to fix uninitialized-variable warning
    The switch in getcuetype() only handled the 5 defined cue-type bit
    patterns, leaving cuetype unassigned (and the compiler warning about
    it) if the top 3 bits of trialio ever hit one of the 3 unused
    patterns. Falls back to the same result as 0B100 (Buzzer, cuetype 0).
    [2_food.ino]
2026-07-17 PWM debugging options
